randomplum/bmp-c/bmp-c.kicad_pcb

## KiCad design bmp-c.kicad_pcb (2019-09-02)

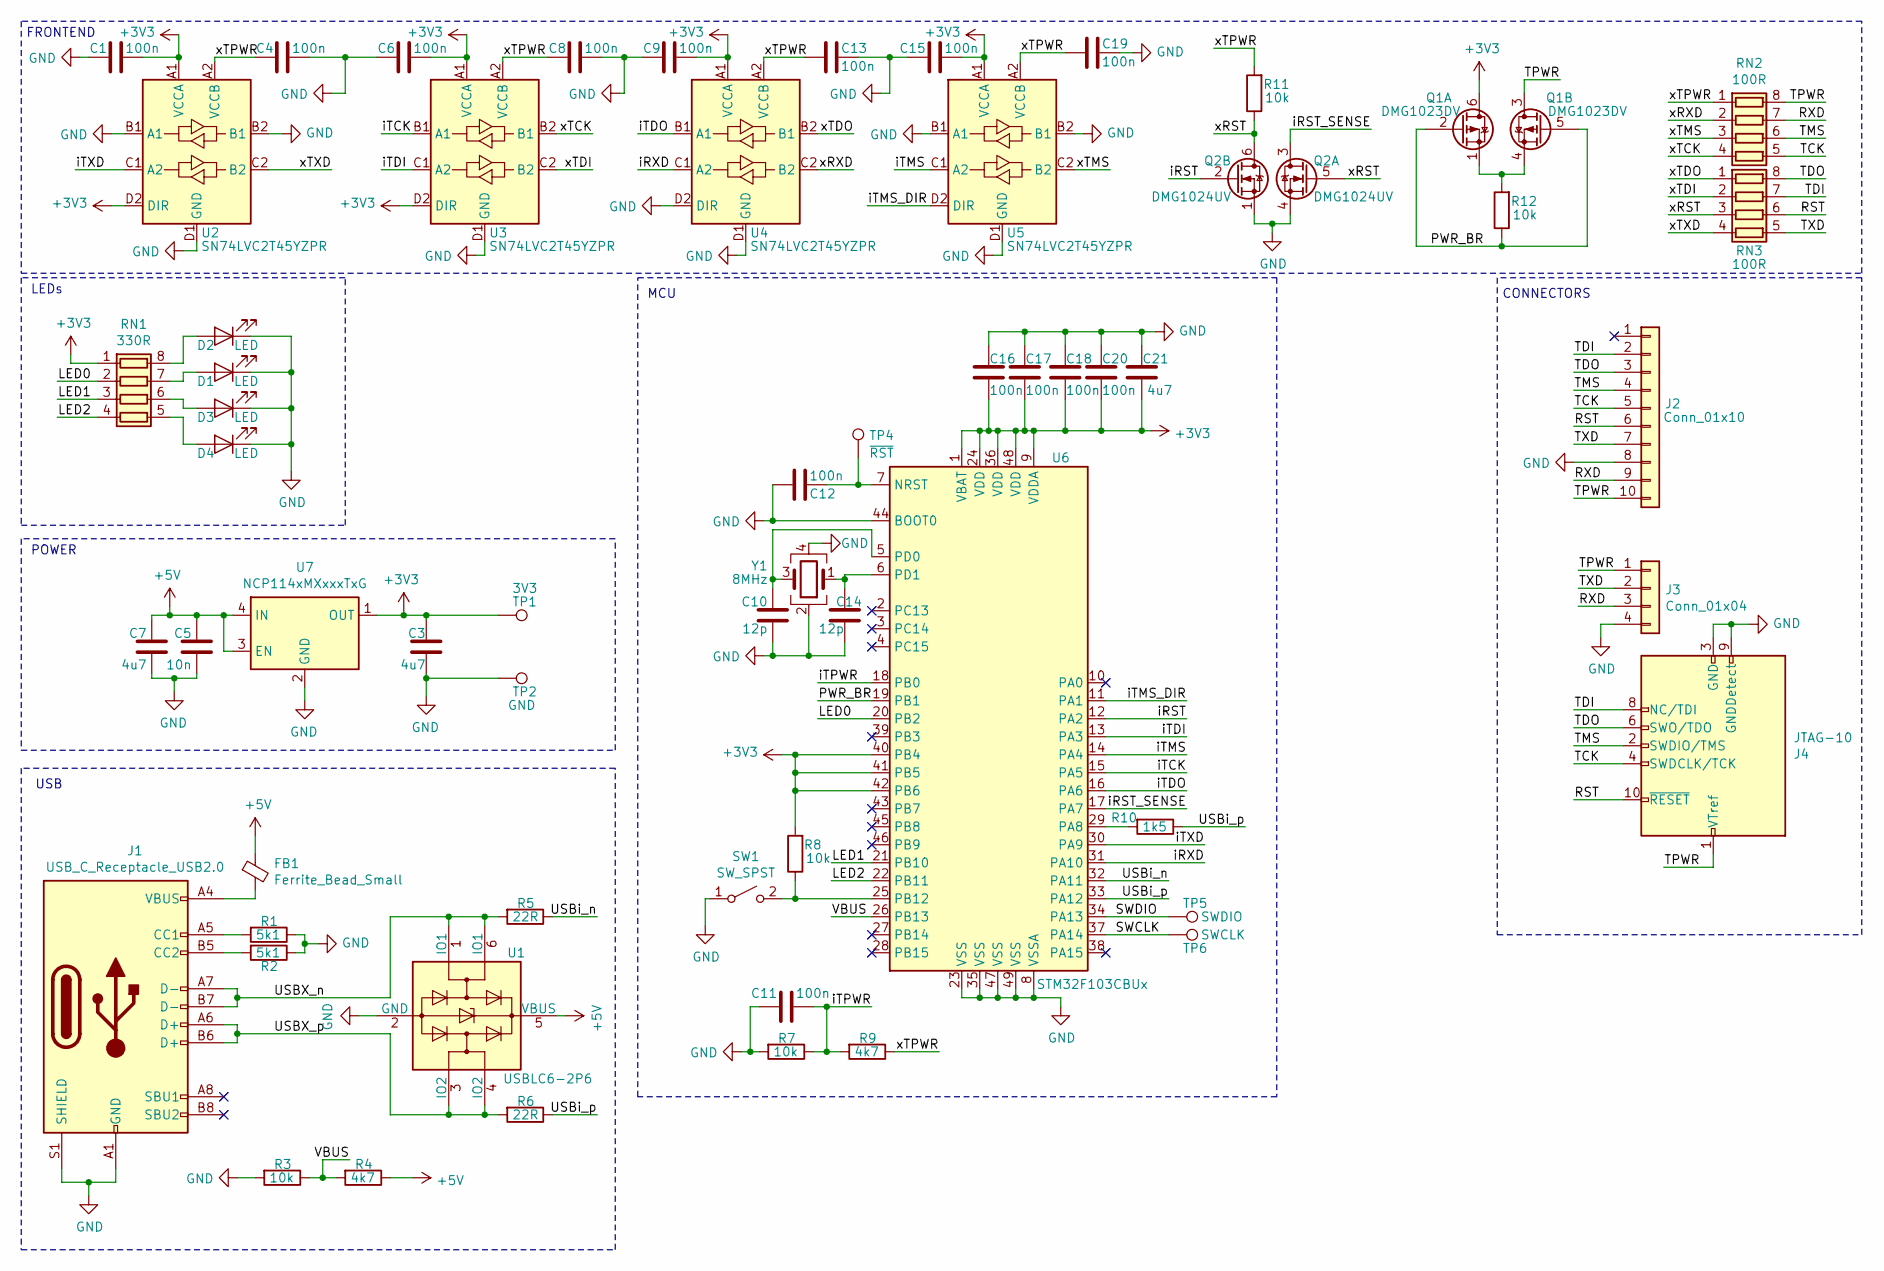
[picture p1: schematic bmp-c.sch, BMPM2-C]

Parts:
C1, C4, C6, C8, C9, C11, C12, C13, C15, C16, C17, C18, C19, C20: 100n; C_0402_1005Metric
C3, C7, C21: 4u7; C_0603_1608Metric
C5: 10n; C_0402_1005Metric
C10, C14: 12p; C_0402_1005Metric
D1, D2, D3, D4: LED; LED_0402_1005Metric
FB1: Ferrite_Bead_Small; Fuse_0603_1608Metric
J1: USB_C_Receptacle_USB2.0; USB_C_Receptacle_HRO_TYPE-C-31-M-12
J2: Conn_01x10; Hirose_FH12-10S-0.5SH_1x10-1MP_P0.50mm_Horizontal
J3: Conn_01x04; JST_SH_SM04B-SRSS-TB_1x04-1MP_P1.00mm_Horizontal
J4: JTAG-10; PinHeader_2x05_P1.27mm_Vertical_SMD
Q1: DMG1023DV; SOT-563
Q2: DMG1024UV; SOT-563
R1, R2: 5k1; R_0402_1005Metric
R3, R7, R8, R11, R12: 10k; R_0402_1005Metric
R4, R9: 4k7; R_0402_1005Metric
R5, R6: 22R; R_0402_1005Metric
R10: 1k5; R_0402_1005Metric
RN1: 330R; R_Array_Convex_4x0402
RN2, RN3: 100R; R_Array_Convex_4x0402
SW1: SW_SPST; SW_SPST_B3U-1000P
TP1: 3V3; TestPoint_Pad_D1.0mm
TP2: GND; TestPoint_Pad_D1.0mm
TP4: ~RST; TestPoint_Pad_D1.0mm
TP5: SWDIO; TestPoint_Pad_D1.0mm
TP6: SWCLK; TestPoint_Pad_D1.0mm
U1: USBLC6-2P6; SOT-666
U2, U3, U4, U5: SN74LVC2T45YZPR; Texas_DSBGA-8_0.9x1.9mm_Layout2x4_P0.5mm
U6: STM32F103CBUx; QFN-48-1EP_7x7mm_P0.5mm_EP5.3x5.3mm_ThermalVias
U7: NCP114xMXxxxTxG; UDFN-4_1x1mm_P0.65mm
Y1: 8MHz; Crystal_SMD_3225-4Pin_3.2x2.5mm

Connections:
+3V3: C1.1, C3.1, C6.1, C9.1, C15.1, C16.2, C17.2, C18.2, C20.2, C21.2, Q1.6 (D), R8.2, RN1.1 (R1.1), TP1.1, U2.A1 (VCCA), U2.D2 (DIR), U3.A1 (VCCA), U3.D2 (DIR), U4.A1 (VCCA), U5.A1 (VCCA), U6.1 (VBAT), U6.9 (VDDA), U6.24 (VDD), U6.36 (VDD), U6.40 (PB4), U6.41 (PB5), U6.42 (PB6), U6.48 (VDD), U7.1 (OUT)
+5V: C5.1, C7.1, FB1.1, R4.1, U1.5 (VBUS), U7.3 (EN), U7.4 (IN)
/LED0: RN1.2 (R2.1), U6.20 (PB2)
/LED1: RN1.3 (R3.1), U6.21 (PB10)
/LED2: RN1.4 (R4.1), U6.22 (PB11)
/PWR_BR: Q1.2 (G), Q1.5 (G), R12.1, U6.19 (PB1)
/RST: J2.6, J4.10 (~RESET~), RN3.6 (R3.2)
/RXD: J2.9, J3.3, RN2.7 (R2.2)
/SWCLK: TP6.1, U6.37 (PA14)
/SWDIO: TP5.1, U6.34 (PA13)
/TCK: J2.5, J4.4 (SWDCLK/TCK), RN2.5 (R4.2)
/TDI: J2.2, J4.8 (NC/TDI), RN3.7 (R2.2)
/TDO: J2.3, J4.6 (SWO/TDO), RN3.8 (R1.2)
/TMS: J2.4, J4.2 (SWDIO/TMS), RN2.6 (R3.2)
/TPWR: J2.10, J3.1, J4.1 (VTref), Q1.3 (D), RN2.8 (R1.2)
/TXD: J2.7, J3.2, RN3.5 (R4.2)
/USBX_n: J1.A7 (D-), J1.B7 (D-), R5.2, U1.1 (IO1), U1.6 (IO1)
/USBX_p: J1.A6 (D+), J1.B6 (D+), R6.2, U1.3 (IO2), U1.4 (IO2)
/USBi_n: R5.1, U6.32 (PA11)
/USBi_p: R6.1, R10.1, U6.33 (PA12)
/VBUS: R3.1, R4.2, U6.26 (PB13)
/iRST: Q2.2 (G), U6.12 (PA2)
/iRST_SENSE: Q2.3 (D), U6.17 (PA7)
/iRXD: U4.C1 (A2), U6.31 (PA10)
/iTCK: U3.B1 (A1), U6.15 (PA5)
/iTDI: U3.C1 (A2), U6.13 (PA3)
/iTDO: U4.B1 (A1), U6.16 (PA6)
/iTMS: U5.C1 (A2), U6.14 (PA4)
/iTMS_DIR: U5.D2 (DIR), U6.11 (PA1)
/iTPWR: C11.1, R7.1, R9.2, U6.18 (PB0)
/iTXD: U2.C1 (A2), U6.30 (PA9)
/xRST: Q2.5 (G), Q2.6 (D), R11.1, RN3.3 (R3.1)
/xRXD: RN2.2 (R2.1), U4.C2 (B2)
/xTCK: RN2.4 (R4.1), U3.B2 (B1)
/xTDI: RN3.2 (R2.1), U3.C2 (B2)
/xTDO: RN3.1 (R1.1), U4.B2 (B1)
/xTMS: RN2.3 (R3.1), U5.C2 (B2)
/xTPWR: C4.2, C8.2, C13.2, C19.2, R9.1, R11.2, RN2.1 (R1.1), U2.A2 (VCCB), U3.A2 (VCCB), U4.A2 (VCCB), U5.A2 (VCCB)
/xTXD: RN3.4 (R4.1), U2.C2 (B2)
GND: C1.2, C3.2, C4.1, C5.2, C6.2, C7.2, C8.1, C9.2, C10.1, C11.2, C12.2, C13.1, C14.1, C15.2, C16.1, C17.1, C18.1, C19.1, C20.1, C21.1, D1.1 (K), D2.1 (K), D3.1 (K), D4.1 (K), J1.A1 (GND), J1.A12 (GND), J1.B1 (GND), J1.B12 (GND), J1.S1 (SHIELD), J2.8, J3.4, J4.3 (GND), J4.5 (GND), J4.9 (GNDDetect), Q2.1 (S), Q2.4 (S), R1.1, R2.1, R3.2, R7.2, SW1.1 (A), TP2.1, U1.2 (GND), U2.B1 (A1), U2.B2 (B1), U2.D1 (GND), U3.D1 (GND), U4.D1 (GND), U4.D2 (DIR), U5.B1 (A1), U5.B2 (B1), U5.D1 (GND), U6.8 (VSSA), U6.23 (VSS), U6.35 (VSS), U6.44 (BOOT0), U6.47 (VSS), U6.49 (VSS), U7.2 (GND), U7.5 (GND), Y1.2, Y1.4
unnamed: C10.2, U6.5 (PD0), Y1.3
unnamed: C12.1, TP4.1, U6.7 (NRST)
unnamed: C14.2, U6.6 (PD1), Y1.1
unnamed: D1.2 (A), RN1.7 (R2.2)
unnamed: D2.2 (A), RN1.8 (R1.2)
unnamed: D3.2 (A), RN1.6 (R3.2)
unnamed: D4.2 (A), RN1.5 (R4.2)
unnamed: FB1.2, J1.A4 (VBUS), J1.A9 (VBUS), J1.B4 (VBUS), J1.B9 (VBUS)
unnamed: J1.A5 (CC1), R1.2
unnamed: J1.B5 (CC2), R2.2
unnamed: Q1.1 (S), Q1.4 (S), R12.2
unnamed: R8.1, SW1.2 (B), U6.25 (PB12)
unnamed: R10.2, U6.29 (PA8)

Notes on the sheet:
USB
POWER
LEDs
FRONTEND
MCU
CONNECTORS

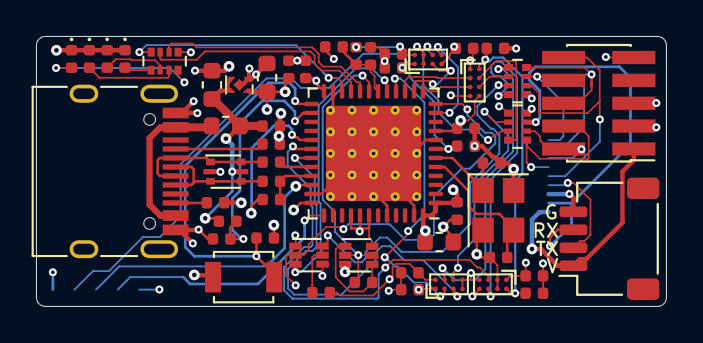
[picture p2: board bmp-c.kicad_pcb from above]

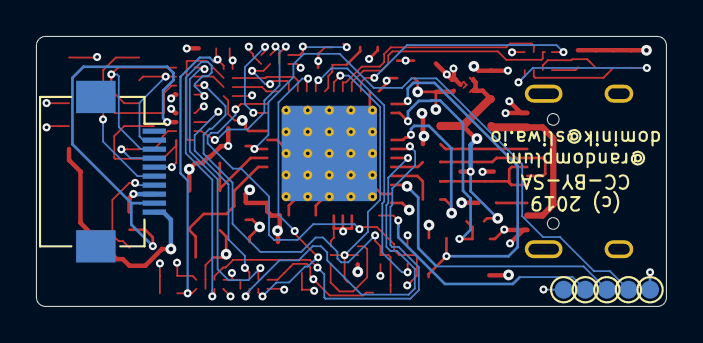
[picture p3: board bmp-c.kicad_pcb from below]

Board: 4 copper layers, 35.0 x 15.0 mm, 60 parts (6 on the bottom side), 53 nets.
