randomplum/bmp-c/(commit log)

2019-08-10 Schematic initial component selection
    [bmp-c.kicad_pcb, bmp-c.sch]
2019-08-11 Finished schematic
    changes
    -Changed resistor arrays to kicad library symbols
    -Fixed FET part numbers
    -Added multiple passive components
    -Added NCP114MX LDO
    [bmp-c.sch]
2019-08-11 Schematic style fixes
    [bmp-c.sch]
2019-08-11 Assign footprints
    [bmp-c.sch]
2019-08-11 Change level-shifter package and schematic fix
    -USBi_p was not conencted to the MCU
    -Use 74LVC2T45 in the DSBGA8 package
    [bmp-c.sch]
2019-08-11 Schematics style fixes
    [bmp-c.sch]
2019-08-11 Fix D1 footprint assigment
    [bmp-c.sch]
2019-08-11 Fix C7 footprint assigment
    [bmp-c.sch]
2019-08-11 Change STM32 footprint to include thermal vias
    [bmp-c.sch]
2019-08-11 Remove version links
    Just hardwire the version
    [bmp-c.sch]
2019-08-11 Remove C2
    [bmp-c.sch]
2019-08-11 use xTPWR as a source for the measurement divider
    [bmp-c.sch]
2019-08-11 remove SWO testpoint
    [bmp-c.sch]
2019-08-12 PCB initial p&r
    [bmp-c.kicad_pcb]
2019-08-12 Fillet the corners
    [bmp-c.kicad_pcb]
2019-08-15 Silkscreen improvementrs
    [bmp-c.kicad_pcb]
2019-09-02 use kicad library symbol for ncp114
    [bmp-c.kicad_pcb, bmp-c.sch]
