randomplum/bmp-c/(notices)

Notices in the files:
bmp-c.sch:
(C) 2019 Dominik Sliwa
License: CC-BY-SA 4.0
bmp-c.kicad_pcb:
(c) 2019
CC-BY-SA
